gremirarunico/PCBs/README.md

# PCBs
## Informazioni
Repository privato per backup & share di PCB realizzati con KiCAD

## KiCad version
7.0.8

## License
Very easy to understand:
All the Hardware in this repository is under CERN-OHL-S v2
All the Software is under GPLv3
All the documentation is under CC-BY-SA 4.0
