gremirarunico/PCBs/MuReSC_BCD_v1/Docs/KL85_MuRESCC.docx

KL85

Multiple-Resonant Switched Capacitor Converter

Test Chip Manual

BCD110AP technology

Advanced IC & Technology Sensitive IPs Design

Smart Power & High Voltage Competence Center

Front-end Technology and Manufacturing - FTM R&D

STMicroelectronics S.r.l.

Castelletto – Italy

Revision 0.1

The purpose of this document is to describe content and control instructions of KL85AA chip included in HI13AA multi-chip in BCD110AP technology, which integrates a Multiple-Resonant Switched Capacitor Converter (MuReSCC), including

- Comparator
- 13MHz clock
- Comparator
- Phase generator with programmable delays
- Drivers
- Output stage

Additional cells are included to allow proper biasing

- Bandgap voltage reference
- PTAT and ZTAT current reference

The used back-end option is 4M2X1UNIPDPI (4 Metals, NiPd Pads with PI). The used front-end option is DTI, with both 1.8V and 5V Gate Oxides.

REVISION HISTORY

Revision | Authors | Release | Notes
0.1 | Alessandro Nicolosi | June 2024 | Document Creation

TECHNOLOGY AND OPERATING CONDITIONS

Name | Version
PDK_STM_BCD110AP | 3.1.a-00
MACROCELLS_ESD_BCD110AP | 1.2-00
BCD110AP_SC_13d5T_CORE_OD50 | 3.0-00
BCD110AP_SC_12T_CORE_H | 3.0-00
BCD110AP_SC_13d5TGO2_SHIFTJI_H_OD50 | 3.0-00
BCD110AP_IO_SFISO_GPIO_1V8_5V_OD50_4M2X1UNIPDPI | 1.0

# 1. Index of contents

# 2. Index of tables

# 3. Index of figures

# 4. KL85 Overview

EXT_REF_SNS_INT_REF

OSC_VCTRL

SEL_INT_REF

RESET

VBATT_COMP

VDD_IO

GND_IO

SENSE_CMP_OUT

SEL_OPEN_LOOP

V1V8

SENSE_OSC_CLK

SEL_CLK

## 4.1. PADRing

The external access (on wafer) to the testchip is shown in Figure 4-1:

48 47 46 45 44 43 42 41 40 39 38 37

ADT_D4

VBATT_PWR

VS1

VOUT

VOUT_SENSE

VS3

GND

VDD_IO

GND_IO

VBATT_DRV

VG4

VG3

EXT_CLK

DT_D0

DT_D1

DT_D2

DT_D3

DT_D4

VDD_IO

GND_IO

ADT_D0

ADT_D1

ADT_D2

ADT_D3

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
13 14 15 16 17 18 19 20 21 22 23 24

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
VBATT

IPTAT_SENSE

IZTAT_SENSE

DRIVE_G1

DRIVE_G2

GND_IO

VDD_IO

DRIVE_G3

DRIVE_G4

SEL_DRIVING

VG1

VG2

Figure 4-1 KL85 Padring and Pinout

In the following table the 48 PADs of the KL85 and their coordinates are reported. All dimensions are provided at CAD level (pre-shrink). To get coordinates at silicon level, you need to apply the optical shrink factor (8%).

Pin count | Name | Type | Description | X | Y
1 | VBATT | SUPPLY | Main input voltage supply for bandgap and current reference
2 | IPTAT_SENSE | ANALOG | Sensing of internal PTAT current reference
3 | IZTAT_SENSE | ANALOG | Sensing of internal ZTAT current reference
4 | DRIVE_G1 | DIG IN | Direct command for driver 1
5 | DRIVE_G2 | DIG IN | Direct command for driver 2
6 | GND_IO | GROUND | Ground for IOs
7 | VDD_IO | SUPPLY | Voltage supply for IOs
8 | DRIVE_G3 | DIG IN | Direct command for driver 3
9 | DRIVE_G4 | DIG IN | Direct command for driver 4
10 | SEL_DRIVING | DIG IN | Selector between internal/external commands for drivers
11 | VG1 | DIG OUT | Pre-driver output 1
12 | VG2 | DIG OUT | Pre-driver output 2
13 | VG3 | DIG OUT | Pre-driver output 3
14 | VG4 | DIG OUT | Pre-driver output 4
15 | VBATT_DRV | SUPPLY | Main input voltage supply for drivers
16 | GND_IO | GROUND | Ground for IOs
17 | VDD_IO | SUPPLY | Voltage supply for IOs
18 | GND | GROUND | Analog and power and substrate ground
19 | VS3 | ANALOG | Intermediate output voltage 3
20 | VOUT_SENSE | ANALOG | Sensing of the output voltage
21 | VOUT | ANALOG | Output voltage
22 | VS1 | ANALOG | Intermediate output voltage 1
23 | VBATT_PWR | SUPPLY | Main input voltage supply for output stage
24 | ADT_D4 | DIG IN | Additional dead time bit 4
25 | ADT_D3 | DIG IN | Additional dead time bit 3
26 | ADT_D2 | DIG IN | Additional dead time bit 2
27 | ADT_D1 | DIG IN | Additional dead time bit 1
28 | ADT_D0 | DIG IN | Additional dead time bit 0
29 | GND_IO | GROUND | Ground for IOs
30 | VDD_IO | SUPPLY | Voltage supply for IOs
31 | DT_D4 | DIG IN | Dead time bit 4
32 | DT_D3 | DIG IN | Dead time bit 3
33 | DT_D2 | DIG IN | Dead time bit 2
34 | DT_D1 | DIG IN | Dead time bit 1
35 | DT_D0 | DIG IN | Dead time bit 0
36 | EXT_CLK | DIG IN | External clock
37 | SEL_CLK | DIG IN | Selector between internal and external clock
38 | SENSE_OSC_CLK | DIG OUT | Oscillator output
39 | V1V8 | SUPPLY | Input voltage supply for 1.8V Circuits
40 | SEL_OPEN_LOOP | DIG IN | Selector between closed and open loop regulation
41 | SENSE_CMP_OUT | DIG OUT | Comparator output
42 | GND_IO | GROUND | Ground for IOs
43 | VDD_IO | SUPPLY | Voltage supply for IOs
44 | VBATT_COMP | SUPPLY | Main input voltage supply for comparator
45 | RESET | DIG IN | Digital global reset (active low)
46 | SEL_INT_REF | DIG IN | Reference Selector
47 | OSC_VCTRL | ANALOG | Oscillator control voltage
48 | EXT_REF_SNS_INT_REF | ANALOG | External reference to bypass internal bandgap or sensing of internal reference

Table 4-1 KL85 Pin list
