gremirarunico/PCBs/MuReSC_GaN_v1/Bom.xlsx

Part number | Farnell number | RS number | Package | Value | Component | Number per part | Description | Price per part | Total price
C1812C124J1GACTU | 2906201 | 146-4328 | 1812 | 120n | C1 | 1 | capacita anello risonanza principle | 1.95 | 1.95
C1206C821J1GACTU |  |  | 1206 | 820p | C2 | 1 | anello multi-risonanza | 0.288 | 0.288
C1812C105K1RACTU | 2522546 |  | 1812 | 1u | Cout | 1 | capacita di uscita | 0.735 | 0.735
ISO7720FD |  |  |  |  |  | 4 | isolatore segnale | 2.26 | 9.04
GS61004B-TR |  |  |  |  |  | 4 | dispositivo di potenza | 6.68 | 26.72
LMG1020YFFR |  | 252-8691 |  |  |  | 4 | Driver GaN | 4.13 | 16.52
TPSM5601R5HRDAR |  |  |  |  |  | 1 | Buck per la logica | 7.29 | 7.29
 |  |  |  |  |  |  |  |  | 0
GRT155R70J105KE01D |  | 260-8843 | 402 | 1u | CD1-4,CLD2,CM5,CM8 | 7 | capacità bypass grande per driver | 0.102 | 0.714
NFM15PC104R1A3D |  |  |  | 0.1u | L2-5 | 4 | capacità bypass per driver | 0.093 | 0.372
MCS0402MC1008FE000 | min 10k 3782647 |  | 402 |  | RH1-4,RL1-4 | 8 | resistenze gate driver | 0.326 | 2.608
MCS04020D1002BE000 |  |  | 402 | 10k | RF1,RM1 | 2 |  | 0.428 | 0.856
MCS04020D2491BE000 |  |  | 402 | 2.49k | RF2 | 1 |  | 0.419 | 0.419
GRJ31CZ72A475KE01L |  |  | 1206 | 4.7u | CIN1,CIN2,CPIN1,CPIN2 | 4 |  | 0.67 | 2.68
C1210C107M8PACTU | 2442786 | 841-0809 | 1210 | 100u | CCV1, CCV2 | 2 |  | 1.04 | 2.08
C0402C104K8RACTU | 2429351 |  | 402 | 100n | CM1-4,6-7,9-10, CISOP1-4, CISOS1-4, CTP1-4, CTS1-4 | 24 |  | 0.093 | 2.232
GRM155R61A475MEAAD | 2688503 |  | 402 | 4.7u | CM0 | 1 |  | 0.121 | 0.121
GRM155Z71A105KE01J | 4128556 |  | 402 | 1u | CLD1 | 1 |  | 0.093 | 0.093
 |  |  |  |  |  |  |  |  | 0
 |  |  |  |  |  |  |  |  | 0
NX3215SA-32.768K-STD-MUS-2 |  |  |  |  |  | 1 | Oscillatore slow | 0.67 | 0.67
GRM0335C1E5R1BA01D |  |  | 201 | 5.1p | COL1-2 | 2 | capacità oscillatore slow | 0.093 | 0.186
GJM0335C1E6R8DB01D |  | 185-3344 | 201 | 6.8p | COH1-2 | 2 | capacità oscillatore fast | 0.093 | 0.186
NX3225SA-24.000M-STD-CSR-1 |  |  |  |  |  | 1 | oscillatore fast | 0.642 | 0.642
 |  |  |  |  |  |  |  |  | 0
PTS526SK15SMTR2LFS | 3780596 | 135-9519 |  |  | SW1-2 | 2 |  | 0.112 | 0.224
ESDALC6V1-1U2 | 1749278 |  | 201 |  | D1-2 | 2 |  | 0.363 | 0.726
MCS04020C3300FE000 | 3546556 |  | 402 | 330 | RUB1 | 1 |  | 0.149 | 0.149
MCS04020C1003FE000 | 2614407 | 188-5959 (https://it.rs-online.com/web/p/resistenze-smd/1885959) | 402 | 100k | RUB2 | 1 |  | 0.149 | 0.149
 |  |  |  |  |  |  |  |  | 0
BLM15AG601SZ1D |  | 104-8521 | 402 |  | BEAD1-2 | 2 |  | 0.093 | 0.186
C0603C106M8PAC7411 | 3508556 |  | 603 |  | CTPB1-4,CTSB1-4 | 8 |  | 0.409 | 3.272
 |  |  |  |  |  |  |  |  | 0
 |  |  |  |  |  |  |  |  | 0
TSZU52C3V3 RGG |  |  |  |  | D3-6 | 3 | zener clamping | 0.409 | 1.227
 |  |  |  |  |  |  |  |  | 0
RT0603DRE077K41L |  |  | 603 | 7.41k | RS2,3 | 2 |  | 0.093 | 0.186
RT0603DRE10100KL | 4013917 |  | 603 | 100k | RS1,4,5,8 | 4 |  | 0.093 | 0.372
RP0603BRD075K76L | 4079327 |  | 603 | 5.76k | RS6,RS7 | 2 |  | 0.363 | 0.726
2222SQ-221GEC | 2287145 |  |  | 220nH | L1 |  |  |  | 0
RP73PF1E2K74BTD | 2944494 |  | 402 | 2.74 | RH1-4,RL1-4 | 8 | Resistenza di gate driver alternativa | 0.316 | 2.528
62000211121 | 3583826 | 233-9506 (https://it.rs-online.com/web/p/strip-e-connettori-pcb/2339506) |  |  |  | 1 |  | 0.307 | 0.307
UCC12040DVE |  |  |  |  |  | 4 | Trasformatore di isolamento | 4.64 | 18.56
LD39050PU33R | 2762703 | 196-1948 (https://it.rs-online.com/web/p/regolatori-di-tensione/1961948) |  |  |  | 1 |  | 1.38 | 1.38
STM32G474RET6 | 3132418 | 193-9861 (https://it.rs-online.com/web/p/microcontroller/1939861) |  |  |  | 1 | micro | 10.42 | 10.42
691214110002 | 1841250 | 191-0080 (https://it.rs-online.com/web/p/morsetti-pcb/1910080) |  |  |  | 2 |  | 0.902 | 1.804
 |  |  |  |  |  |  |  | TOTAL | 118.618
