gremirarunico/PCBs/MuReSC_BCD_v1/Docs/Pins.xlsx

Sheet: Sheet1
Power pins
VBATT | power | Alimentazione 5V per componenti accessori
VBATTDRIVER | power | Alimentazione 5V per driving power MOS
VBATTPOWER | power | Alimentazione 5V per la conversione
gnd | power | ground
1v8 | power | 1.8V per alimentazione logica
Config pin |  | disponibili per registri
adt_0 | digital | Configurazione ritardo 4° MOS
adt_1 | digital
adt_2 | digital
adt_3 | digital
adt_4 | digital
dt_d0 | digital | Configurazione Dead Time
dt_d1 | digital
dt_d2 | digital
dt_d3 | digital
dt_d4 | digital
INPUT PIN
DRIVE_G1 | digital | Manual driving gate
DRIVE_G2 | digital
DRIVE_G3 | digital
DRIVE_G4 | digital
SEL_DRIVING | digital | Selezione se driving esterno
SEL_OPENLOOP | digital | Seleziona se attivare o disattivare il controllo interno ad isteresi
EXT_CLK | digital | Clock esterno se desiderato
SEL_CLK | digital | Selezione clock esterno
OUTPUTPIN
VG1 | analog | Tensione sense per gate power MOS
VG2 | analog
VG3 | analog
VG4 | analog
Vout | analog | Uscita
VS3 | analog | Pin Induttanza
VS1 | analog | Pin capacità monorisonanza
SENSE_OSC_CLK | digital | Clock interno fuori

Sheet: Sheet2
PINLIST
# | NAME | ACCESS | DESCRIPTION
1 | VBATT | SUPPLY | Main input voltage supply for bandgap and current reference | BG
2 | IPTAT_SENSE | ANALOG | Sensing of internal PTAT current reference | BG
3 | IZTAT_SENSE | ANALOG | Sensing of internal ZTAT current reference | BG
4 | DRIVE_G1 | DIG IN | Direct command for driver 1 | DRV
5 | DRIVE_G2 | DIG IN | Direct command for driver 2 | DRV
6 | GND_IO | GROUND | Ground for IOs
7 | VDD_IO | SUPPLY | Voltage supply for IOs
8 | DRIVE_G3 | DIG IN | Direct command for driver 3 | DRV
9 | DRIVE_G4 | DIG IN | Direct command for driver 4 | DRV
10 | SEL_DRIVING | DIG IN | Selector between internal/external commands for drivers | DRV
11 | VG1 | DIG OUT | Pre-driver output 1 | DRV
12 | VG2 | DIG OUT | Pre-driver output 2 | DRV
13 | VG3 | DIG OUT | Pre-driver output 3 | DRV
14 | VG4 | DIG OUT | Pre-driver output 4 | DRV
15 | VBATT_DRV | SUPPLY | Main input voltage supply for drivers | DRV
16 | GND_IO | GROUND | Ground for IOs
17 | VDD_IO | SUPPLY | Voltage supply for IOs
18 | GND | GROUND | Analog and power and substrate ground | PWR
19 | VS3 | ANALOG | Intermediate output voltage 3 | PWR
20 | VOUT_SENSE | ANALOG | Sensing of the output voltage | PWR
21 | VOUT | ANALOG | Output voltage | PWR
22 | VS1 | ANALOG | Intermediate output voltage 1 | PWR
23 | VBATT_POWER | SUPPLY | Main input voltage supply for output stage | PWR
24 | ADT_D4 | DIG IN | Additional dead time bit 4 | DRV
25 | ADT_D3 | DIG IN | Additional dead time bit 3 | DRV
26 | ADT_D2 | DIG IN | Additional dead time bit 2 | DRV
27 | ADT_D1 | DIG IN | Additional dead time bit 1 | DRV
28 | ADT_D0 | DIG IN | Additional dead time bit 0 | DRV
29 | GND_IO | GROUND | Ground for IOs
30 | VDD_IO | SUPPLY | Voltage supply for IOs
31 | DT_D4 | DIG IN | Dead time bit 4 | DRV
32 | DT_D3 | DIG IN | Dead time bit 3 | DRV
33 | DT_D2 | DIG IN | Dead time bit 2 | DRV
34 | DT_D1 | DIG IN | Dead time bit 1 | DRV
35 | DT_D0 | DIG IN | Dead time bit 0 | DRV
36 | EXT_CLK | DIG IN | External clock | CLK
37 | SEL_CLK | DIG IN | Selector between internal and external clock | CLK
38 | SENSE_OSC_CLK | DIG OUT | Oscillator output | CLK
39 | V1V8 | SUPPLY | Input voltage supply for 1.8V Circuits | CLK
40 | SEL_OPEN_LOOP | DIG IN | Selector between closed and open loop regulation | COMP
41 | SENSE_CMP_OUT | DIG OUT | Comparator output | COMP
42 | GND_IO | GROUND | Ground for IOs
43 | VDD_IO | SUPPLY | Voltage supply for IOs
44 | VBATT_COMP | SUPPLY | Main input voltage supply for comparator | COMP
45 | RESET | DIG IN | Digital global reset (active low) | CLK
46 | SEL_INT_REF | DIG IN | Reference Selector | BG
47 | OSC_VCTRL | ANALOG | Oscillator control voltage | CLK
48 | EXT_REF_SNS_INT_REF | ANALOG | External reference to bypass internal bandgap or sense of internal reference | BG
