gremirarunico/PCBs/MuReSC_BCD_v1/Docs/BOM.xlsx

Cosa | Codice | Quantità ps | Quantità | Spiegazione | Costo per unità | Costo totale
LDO | SPX3819M5-L-1-8/TR | 1 | 10 |  | 0.38 € | 3.81 €
CAVO | 415-0199-MM500 | 0 | 8 | 4 canali oscilloscopio + 4 canali generatore di segnali | 9.72 € | 77.76 €
BNC | 60312002114503 | 13 | 50 |  | 5.36 € | 268.00 €
R100k | RT0603DRE10100KL | 21 |  |  | 0.09 €
Jumper | 382811-8 | 8 |  |  | 0.15 €
R1k | RP0603BRE071KL | 2 |  |  | 0.20 €
RV100k | TS63Y104KT20 | 1 |  |  | 2.67 €
INTERRUTTORE | 653-A6S-5102-H | 3 |  |  | 2.24 €
Clamp | 691214110002 | 3 | 0
L21.5nH | 0908SQ-22N | 1 |  |  | 2.16 €
L16.6nH | 0908SQ-17N
L14.7nH | 0908SQ-14N
L12.1nH | 0908SQ-12N
L8.1nH | 0908SQ-8N1
L23nH | 0908SQ-23N
l25nH | 0908SQ-25N
L27.3nH | 0908SQ-27N
https://www.coilcraft.com/getmedia/b4a6ff85-4c1f-448e-aea7-541369538706/sq_spring.pdf
