gremirarunico/PCBs/MuReSC_BCD_v1/MuReSC_BCD.kicad_pcb

## KiCad design MuReSC_BCD_v1/MuReSC_BCD.kicad_pcb (2025-04-28)

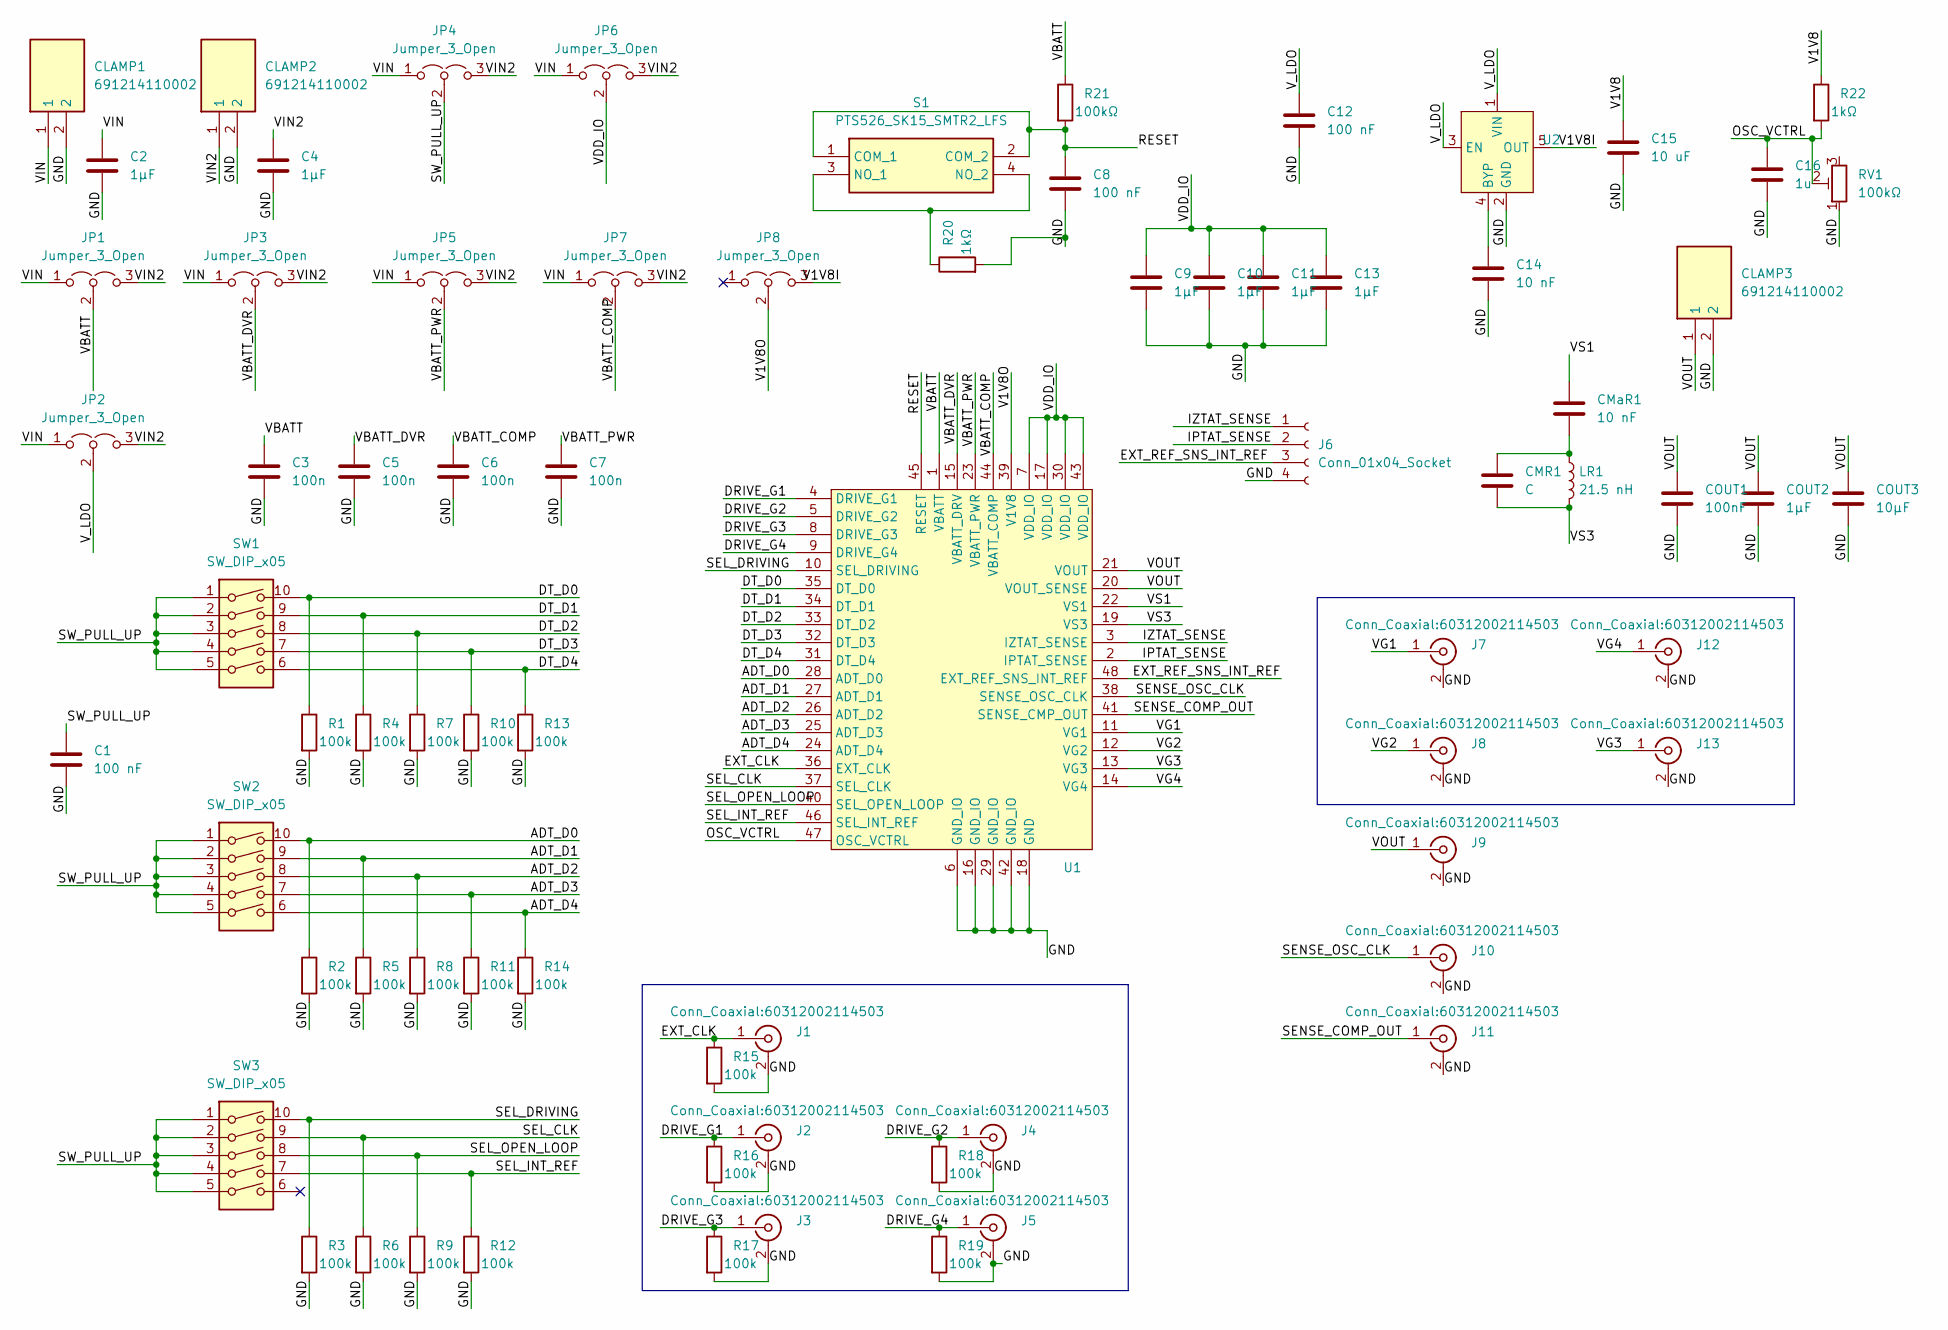
[picture p1: schematic MuReSC_BCD.kicad_sch]

Parts:
C1, C8, C12: 100 nF; C_0603_1608Metric_Pad1.08x0.95mm_HandSolder
C2, C4, C9, C10, C11, C13: 1µF; C_0603_1608Metric_Pad1.08x0.95mm_HandSolder
C3, C5, C6, C7: 100n; C_0603_1608Metric_Pad1.08x0.95mm_HandSolder
C14: 10 nF; C_0603_1608Metric_Pad1.08x0.95mm_HandSolder
C15: 10 uF; C_0603_1608Metric_Pad1.08x0.95mm_HandSolder
C16: 1u; C_0603_1608Metric_Pad1.08x0.95mm_HandSolder
CLAMP1, CLAMP2, CLAMP3: 691214110002; Mouser Part Number 710-691214110002
CMR1: C; C_0603_1608Metric_Pad1.08x0.95mm_HandSolder
CMaR1: 10 nF; C_0603_1608Metric_Pad1.08x0.95mm_HandSolder
COUT1: 100nF; C_0603_1608Metric_Pad1.08x0.95mm_HandSolder
COUT2: 1µF; C_0603_1608Metric_Pad1.08x0.95mm_HandSolder
COUT3: 10µF; C_0603_1608Metric_Pad1.08x0.95mm_HandSolder
J1, J2, J3, J4, J5, J7, J8, J9, J10, J11, J12, J13: Conn_Coaxial:60312002114503; SMA_Wurth_60312002114503_Vertical
J6: Conn_01x04_Socket; PinHeader_1x04_P2.54mm_Vertical
JP1, JP2, JP3, JP4, JP5, JP6, JP7, JP8: Jumper_3_Open; PinHeader_1x03_P2.54mm_Vertical
LR1: 21.5 nH; Coilcraft-Square-Air-Core-Inductors-all
R1, R2, R3, R4, R5, R6, R7, R8, R9, R10, R11, R12, R13, R14, R15, R16, R17, R18, R19: 100k; R_0603_1608Metric_Pad0.98x0.95mm_HandSolder
R20, R22: 1kΩ; R_0603_1608Metric_Pad0.98x0.95mm_HandSolder
R21: 100kΩ; R_0603_1608Metric_Pad0.98x0.95mm_HandSolder
RV1: 100kΩ; TS63X-VISHAY
S1: PTS526_SK15_SMTR2_LFS; PTS526SK15SMTR2LFS; Mouser Part Number 611-PTS526SK15SMR2L
SW1, SW2, SW3: SW_DIP_x05; DIP-10_W10.16mm_LongPads
U1: TQFP-48_7x7mm_P0.5mm
U2: SOT-23-5_HandSoldering

Connections:
/ADT_D0: R2.1, SW2.10, U1.28 (ADT_D0)
/ADT_D1: R5.1, SW2.9, U1.27 (ADT_D1)
/ADT_D2: R8.1, SW2.8, U1.26 (ADT_D2)
/ADT_D3: R11.1, SW2.7, U1.25 (ADT_D3)
/ADT_D4: R14.1, SW2.6, U1.24 (ADT_D4)
/DRIVE_G1: J2.1 (In), R16.1, U1.4 (DRIVE_G1)
/DRIVE_G2: J4.1 (In), R18.1, U1.5 (DRIVE_G2)
/DRIVE_G3: J3.1 (In), R17.1, U1.8 (DRIVE_G3)
/DRIVE_G4: J5.1 (In), R19.1, U1.9 (DRIVE_G4)
/DT_D0: R1.1, SW1.10, U1.35 (DT_D0)
/DT_D1: R4.1, SW1.9, U1.34 (DT_D1)
/DT_D2: R7.1, SW1.8, U1.33 (DT_D2)
/DT_D3: R10.1, SW1.7, U1.32 (DT_D3)
/DT_D4: R13.1, SW1.6, U1.31 (DT_D4)
/EXT_CLK: J1.1 (In), R15.1, U1.36 (EXT_CLK)
/EXT_REF_SNS_INT_REF: J6.3, U1.48 (EXT_REF_SNS_INT_REF)
/GND: C1.2, C2.2, C3.2, C4.2, C5.2, C6.2, C7.2, C8.2, C9.2, C10.2, C11.2, C12.2, C13.2, C14.2, C15.2, C16.2, CLAMP1.2, CLAMP2.2, CLAMP3.2, COUT1.2, COUT2.2, COUT3.2, J1.2 (Ext), J2.2 (Ext), J3.2 (Ext), J4.2 (Ext), J5.2 (Ext), J6.4, J7.2 (Ext), J8.2 (Ext), J9.2 (Ext), J10.2 (Ext), J11.2 (Ext), J12.2 (Ext), J13.2 (Ext), R1.2, R2.2, R3.2, R4.2, R5.2, R6.2, R7.2, R8.2, R9.2, R10.2, R11.2, R12.2, R13.2, R14.2, R15.2, R16.2, R17.2, R18.2, R19.2, R20.2, RV1.1, U1.6 (GND_IO), U1.16 (GND_IO), U1.18 (GND), U1.29 (GND_IO), U1.42 (GND_IO), U2.2 (GND)
/IPTAT_SENSE: J6.2, U1.2 (IPTAT_SENSE)
/IZTAT_SENSE: J6.1, U1.3 (IZTAT_SENSE)
/OSC_VCTRL: C16.1, R22.2, RV1.2, U1.47 (OSC_VCTRL)
/RESET: C8.1, R21.2, S1.1 (COM_1), S1.2 (COM_2), U1.45 (RESET)
/SEL_CLK: R6.1, SW3.9, U1.37 (SEL_CLK)
/SEL_DRIVING: R3.1, SW3.10, U1.10 (SEL_DRIVING)
/SEL_INT_REF: R12.1, SW3.7, U1.46 (SEL_INT_REF)
/SEL_OPEN_LOOP: R9.1, SW3.8, U1.40 (SEL_OPEN_LOOP)
/SENSE_COMP_OUT: J11.1 (In), U1.41 (SENSE_CMP_OUT)
/SENSE_OSC_CLK: J10.1 (In), U1.38 (SENSE_OSC_CLK)
/SW_PULL_UP: C1.1, JP4.2 (C), SW1.1, SW1.2, SW1.3, SW1.4, SW1.5, SW2.1, SW2.2, SW2.3, SW2.4, SW2.5, SW3.1, SW3.2, SW3.3, SW3.4, SW3.5
/V1V8: C15.1, R22.1
/V1V8I: JP8.3 (B), U2.5 (OUT)
/V1V8O: JP8.2 (C), U1.39 (V1V8)
/VBATT: C3.1, JP1.2 (C), R21.1, U1.1 (VBATT)
/VBATT_COMP: C6.1, JP7.2 (C), U1.44 (VBATT_COMP)
/VBATT_DVR: C5.1, JP3.2 (C), U1.15 (VBATT_DRV)
/VBATT_PWR: C7.1, JP5.2 (C), U1.23 (VBATT_PWR)
/VDD_IO: C9.1, C10.1, C11.1, C13.1, JP6.2 (C), U1.7 (VDD_IO), U1.17 (VDD_IO), U1.30 (VDD_IO), U1.43 (VDD_IO)
/VG1: J7.1 (In), U1.11 (VG1)
/VG2: J8.1 (In), U1.12 (VG2)
/VG3: J13.1 (In), U1.13 (VG3)
/VG4: J12.1 (In), U1.14 (VG4)
/VIN: C2.1, CLAMP1.1, JP1.1 (A), JP2.1 (A), JP3.1 (A), JP4.1 (A), JP5.1 (A), JP6.1 (A), JP7.1 (A)
/VIN2: C4.1, CLAMP2.1, JP1.3 (B), JP2.3 (B), JP3.3 (B), JP4.3 (B), JP5.3 (B), JP6.3 (B), JP7.3 (B)
/VOUT: CLAMP3.1, COUT1.1, COUT2.1, COUT3.1, J9.1 (In), U1.20 (VOUT_SENSE), U1.21 (VOUT)
/VS1: CMaR1.1, U1.22 (VS1)
/VS3: CMR1.2, LR1.2, U1.19 (VS3)
/V_LDO: C12.1, JP2.2 (C), U2.1 (VIN), U2.3 (EN)
unnamed: CMR1.1, CMaR1.2, LR1.1
unnamed: R20.1, S1.3 (NO_1), S1.4 (NO_2)
unnamed: C14.1, U2.4 (BYP)

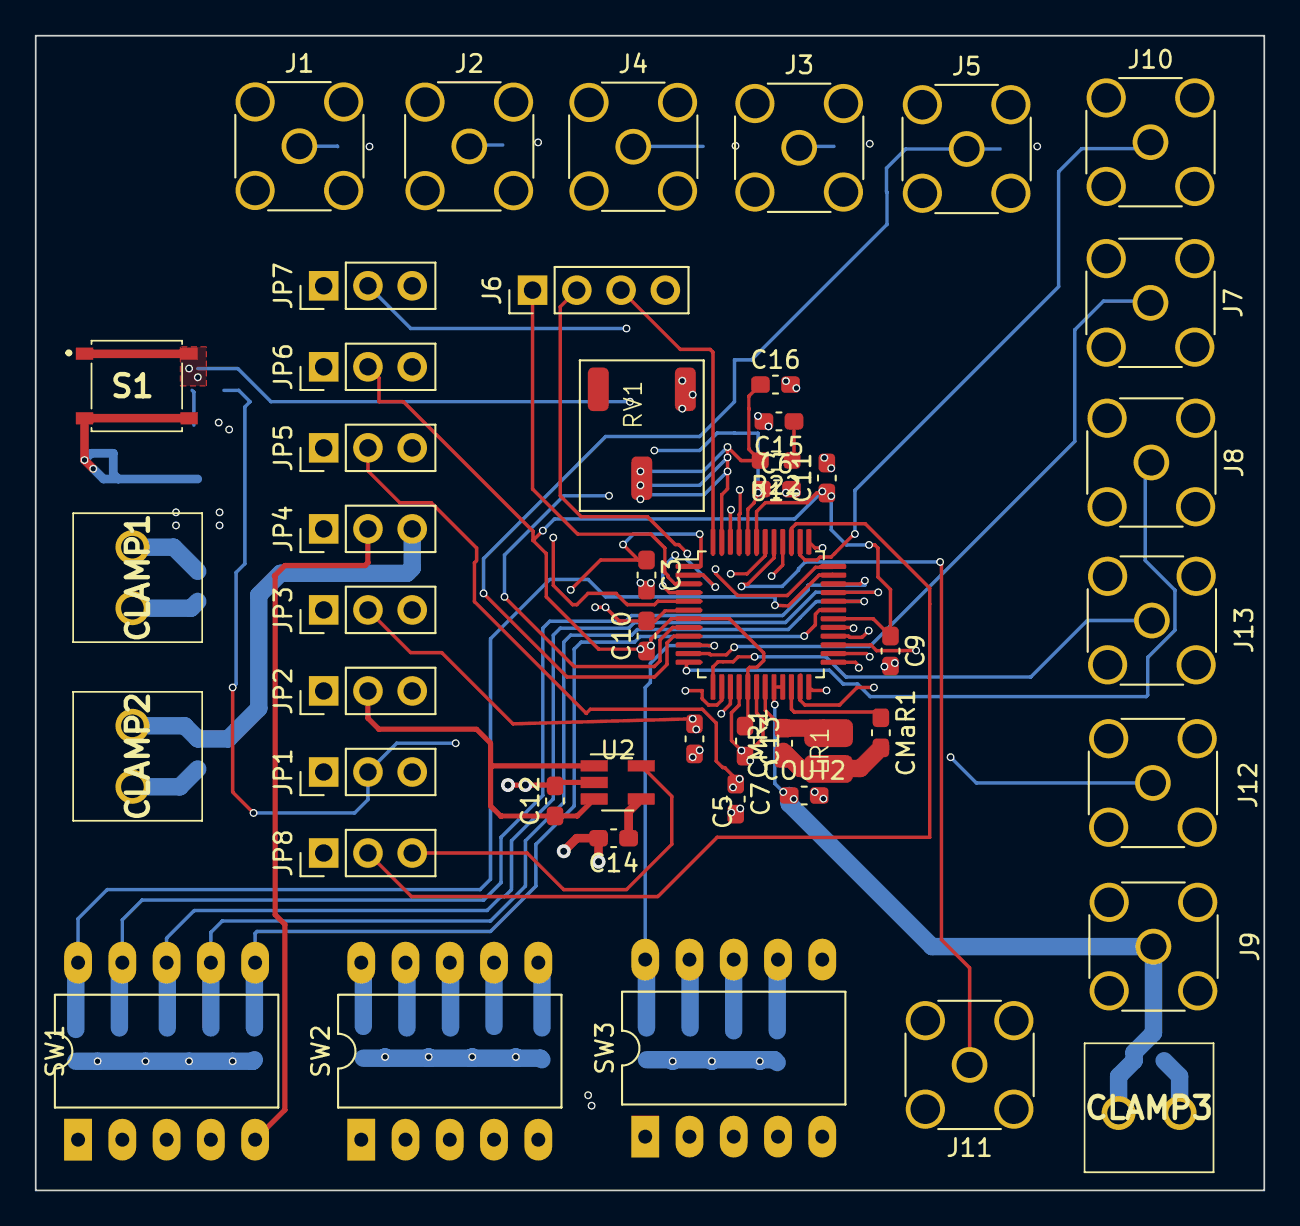
[picture p2: board MuReSC_BCD.kicad_pcb from above]

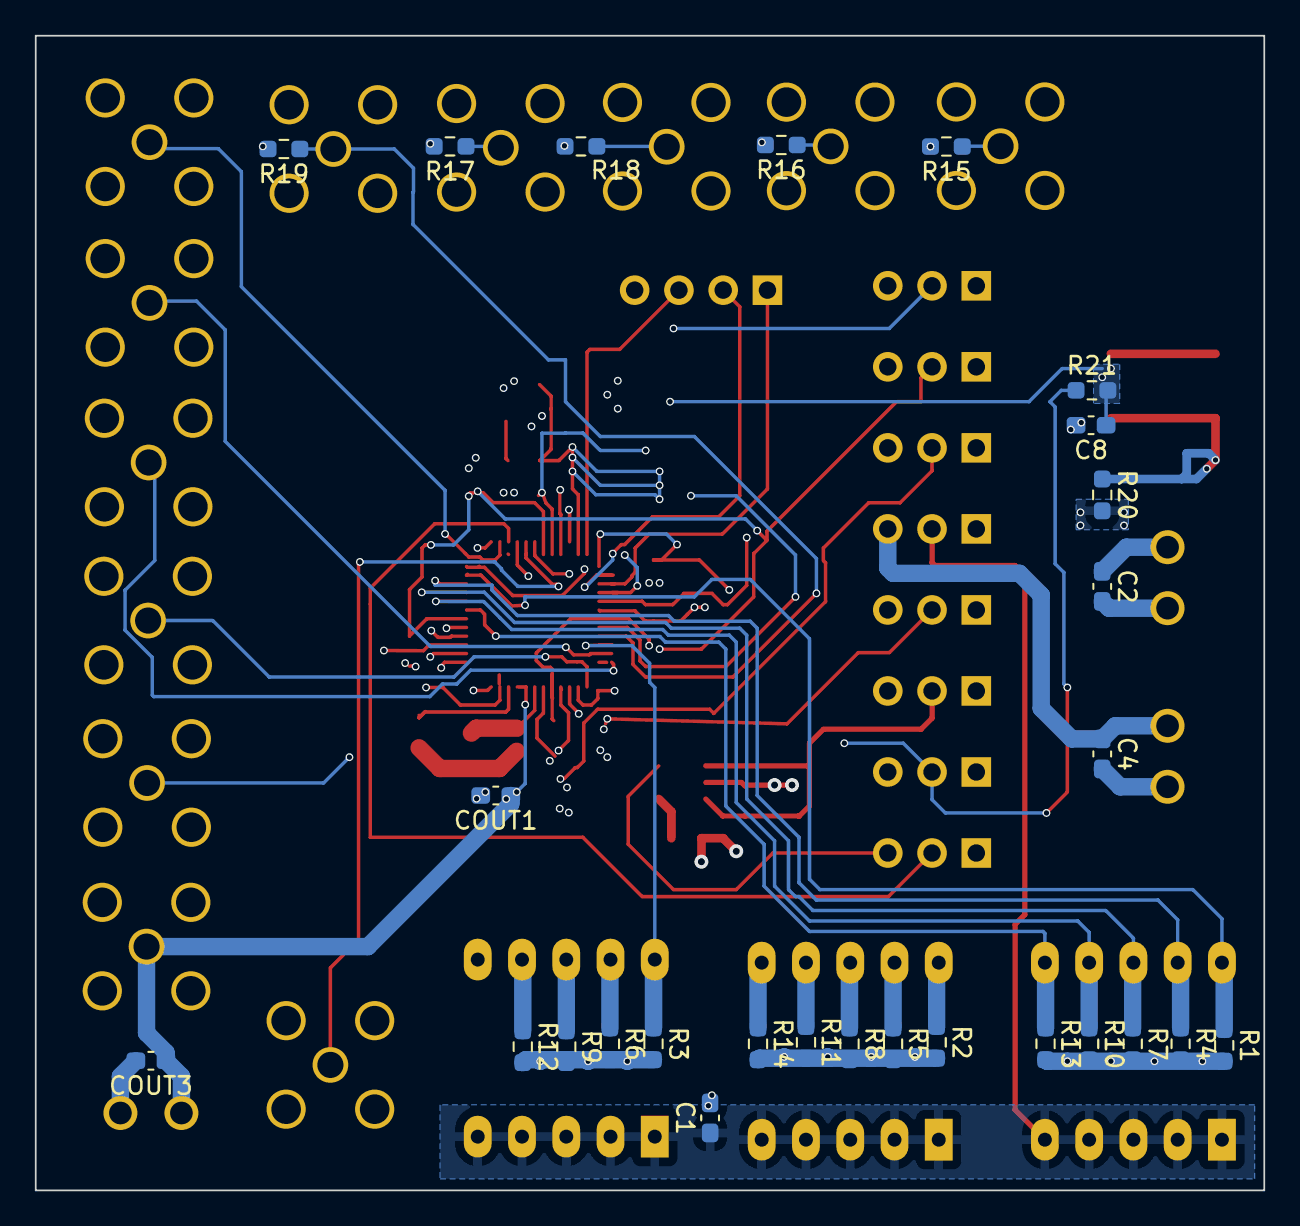
[picture p3: board MuReSC_BCD.kicad_pcb from below]

Board: 4 copper layers, 70.5 x 66.3 mm, 75 parts (27 on the bottom side), 49 nets.
