gremirarunico/PCBs/MuReSC_GaN_v1/Project.kicad_pcb

## KiCad design MuReSC_GaN_v1/Project.kicad_pcb (2025-04-16)

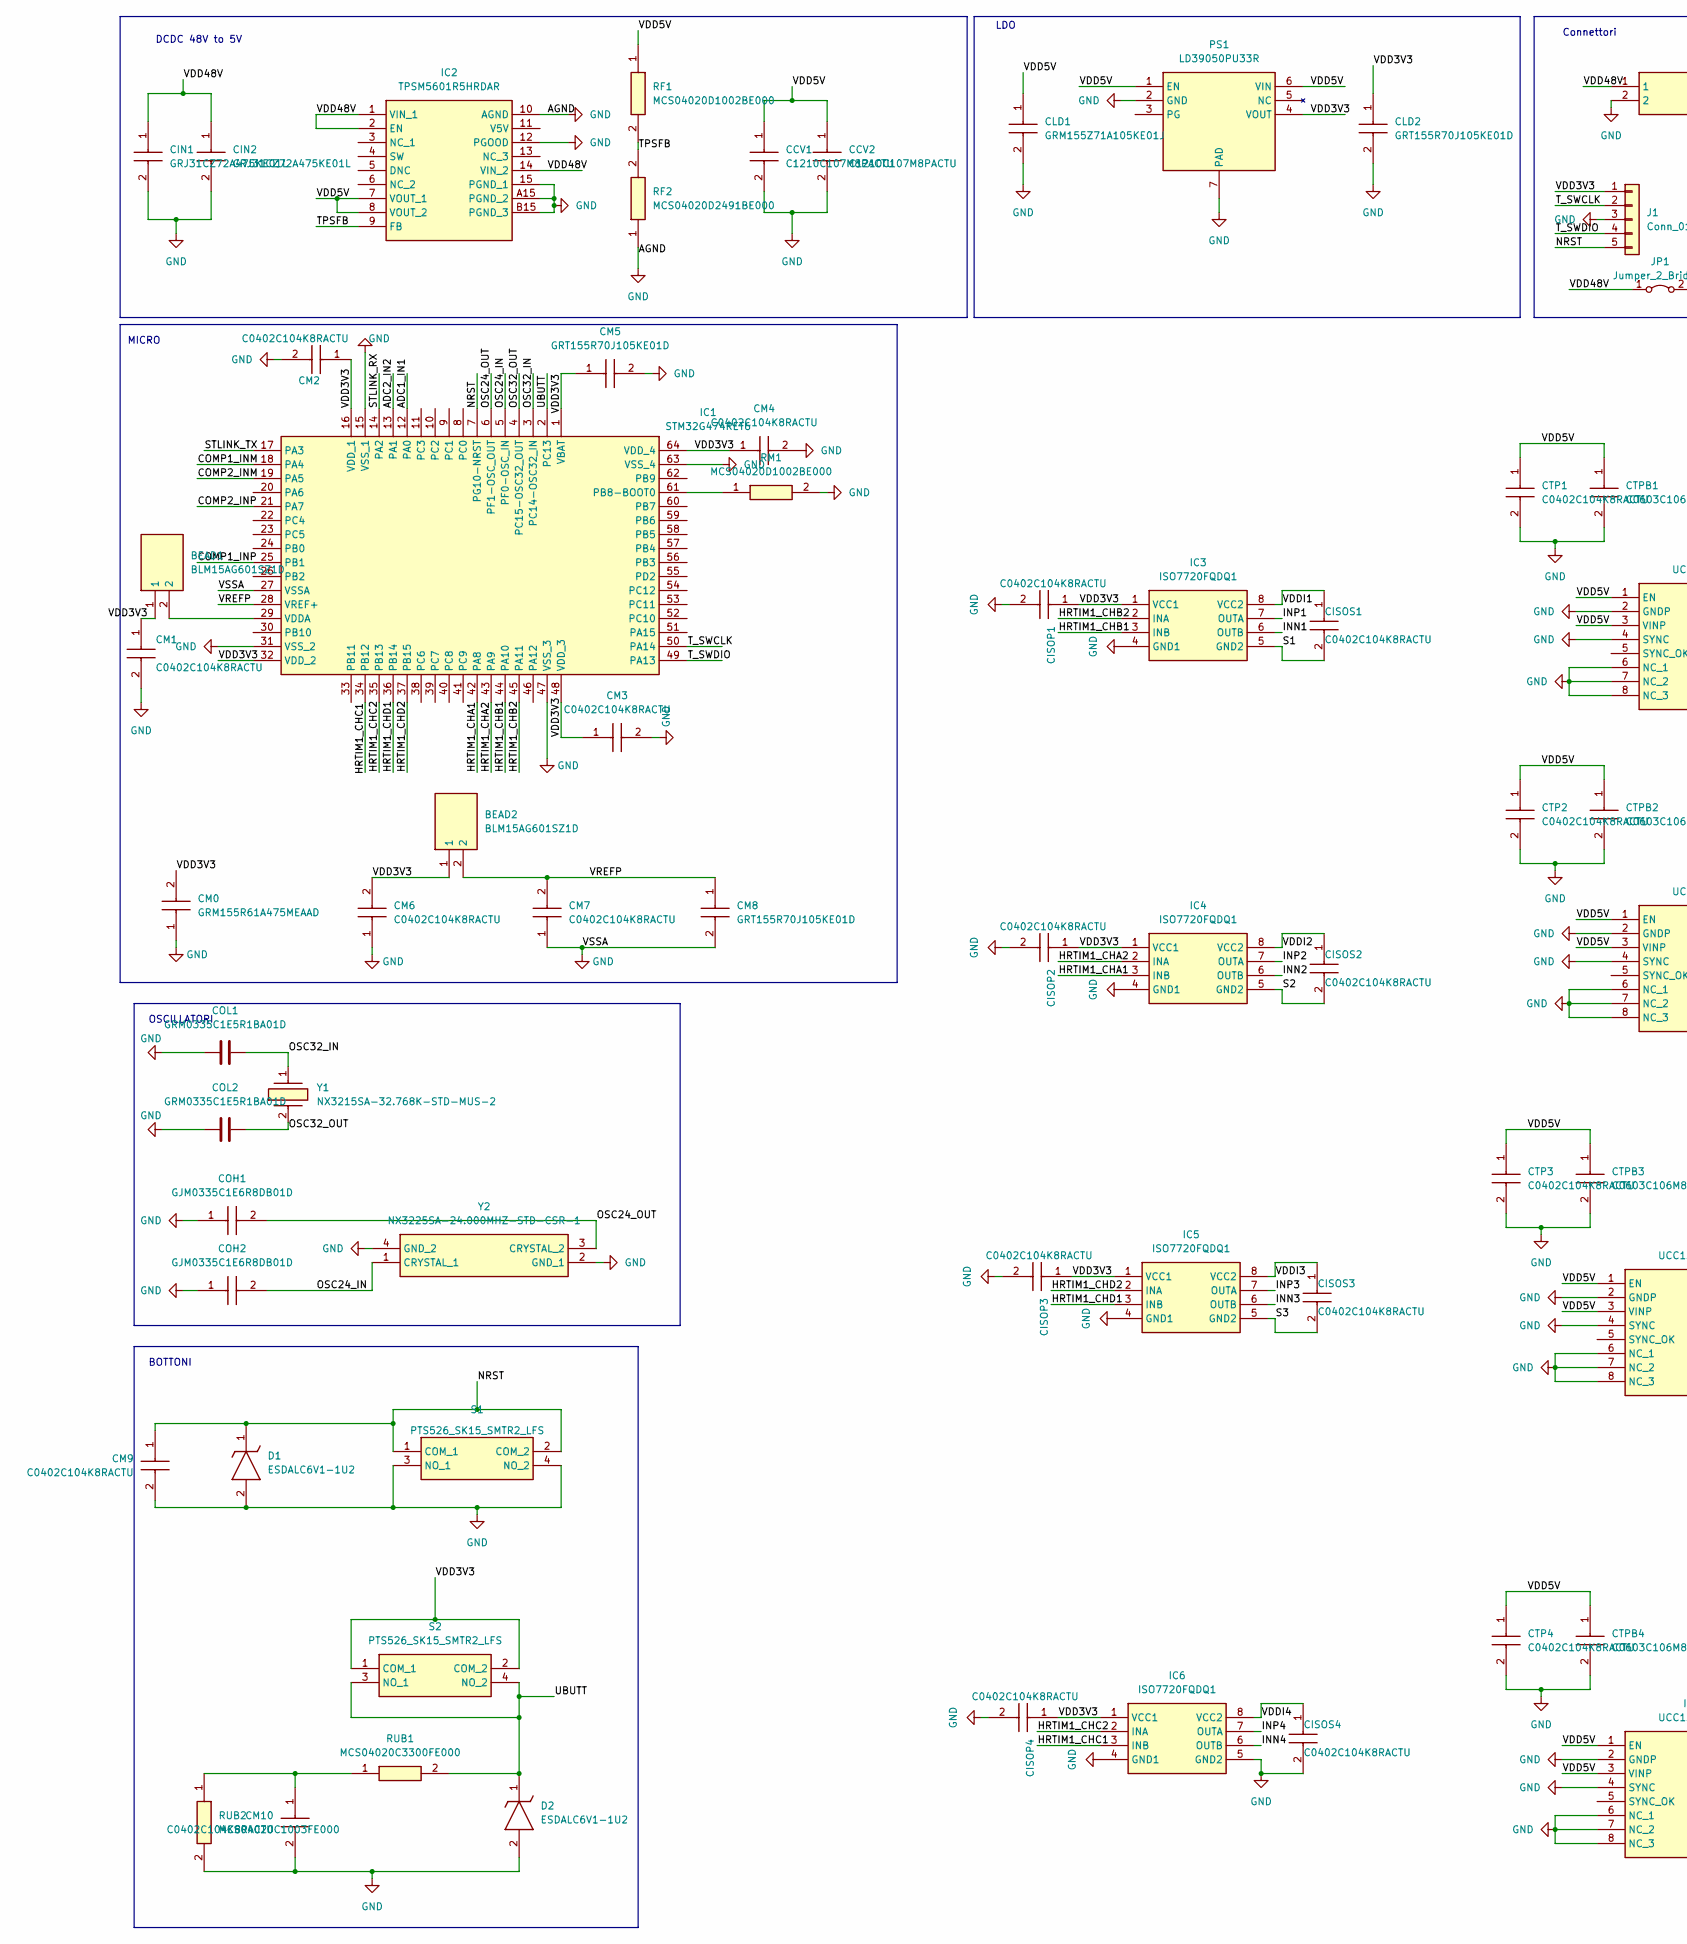
[picture p4: schematic Project.kicad_sch, part in row 1, column 1]

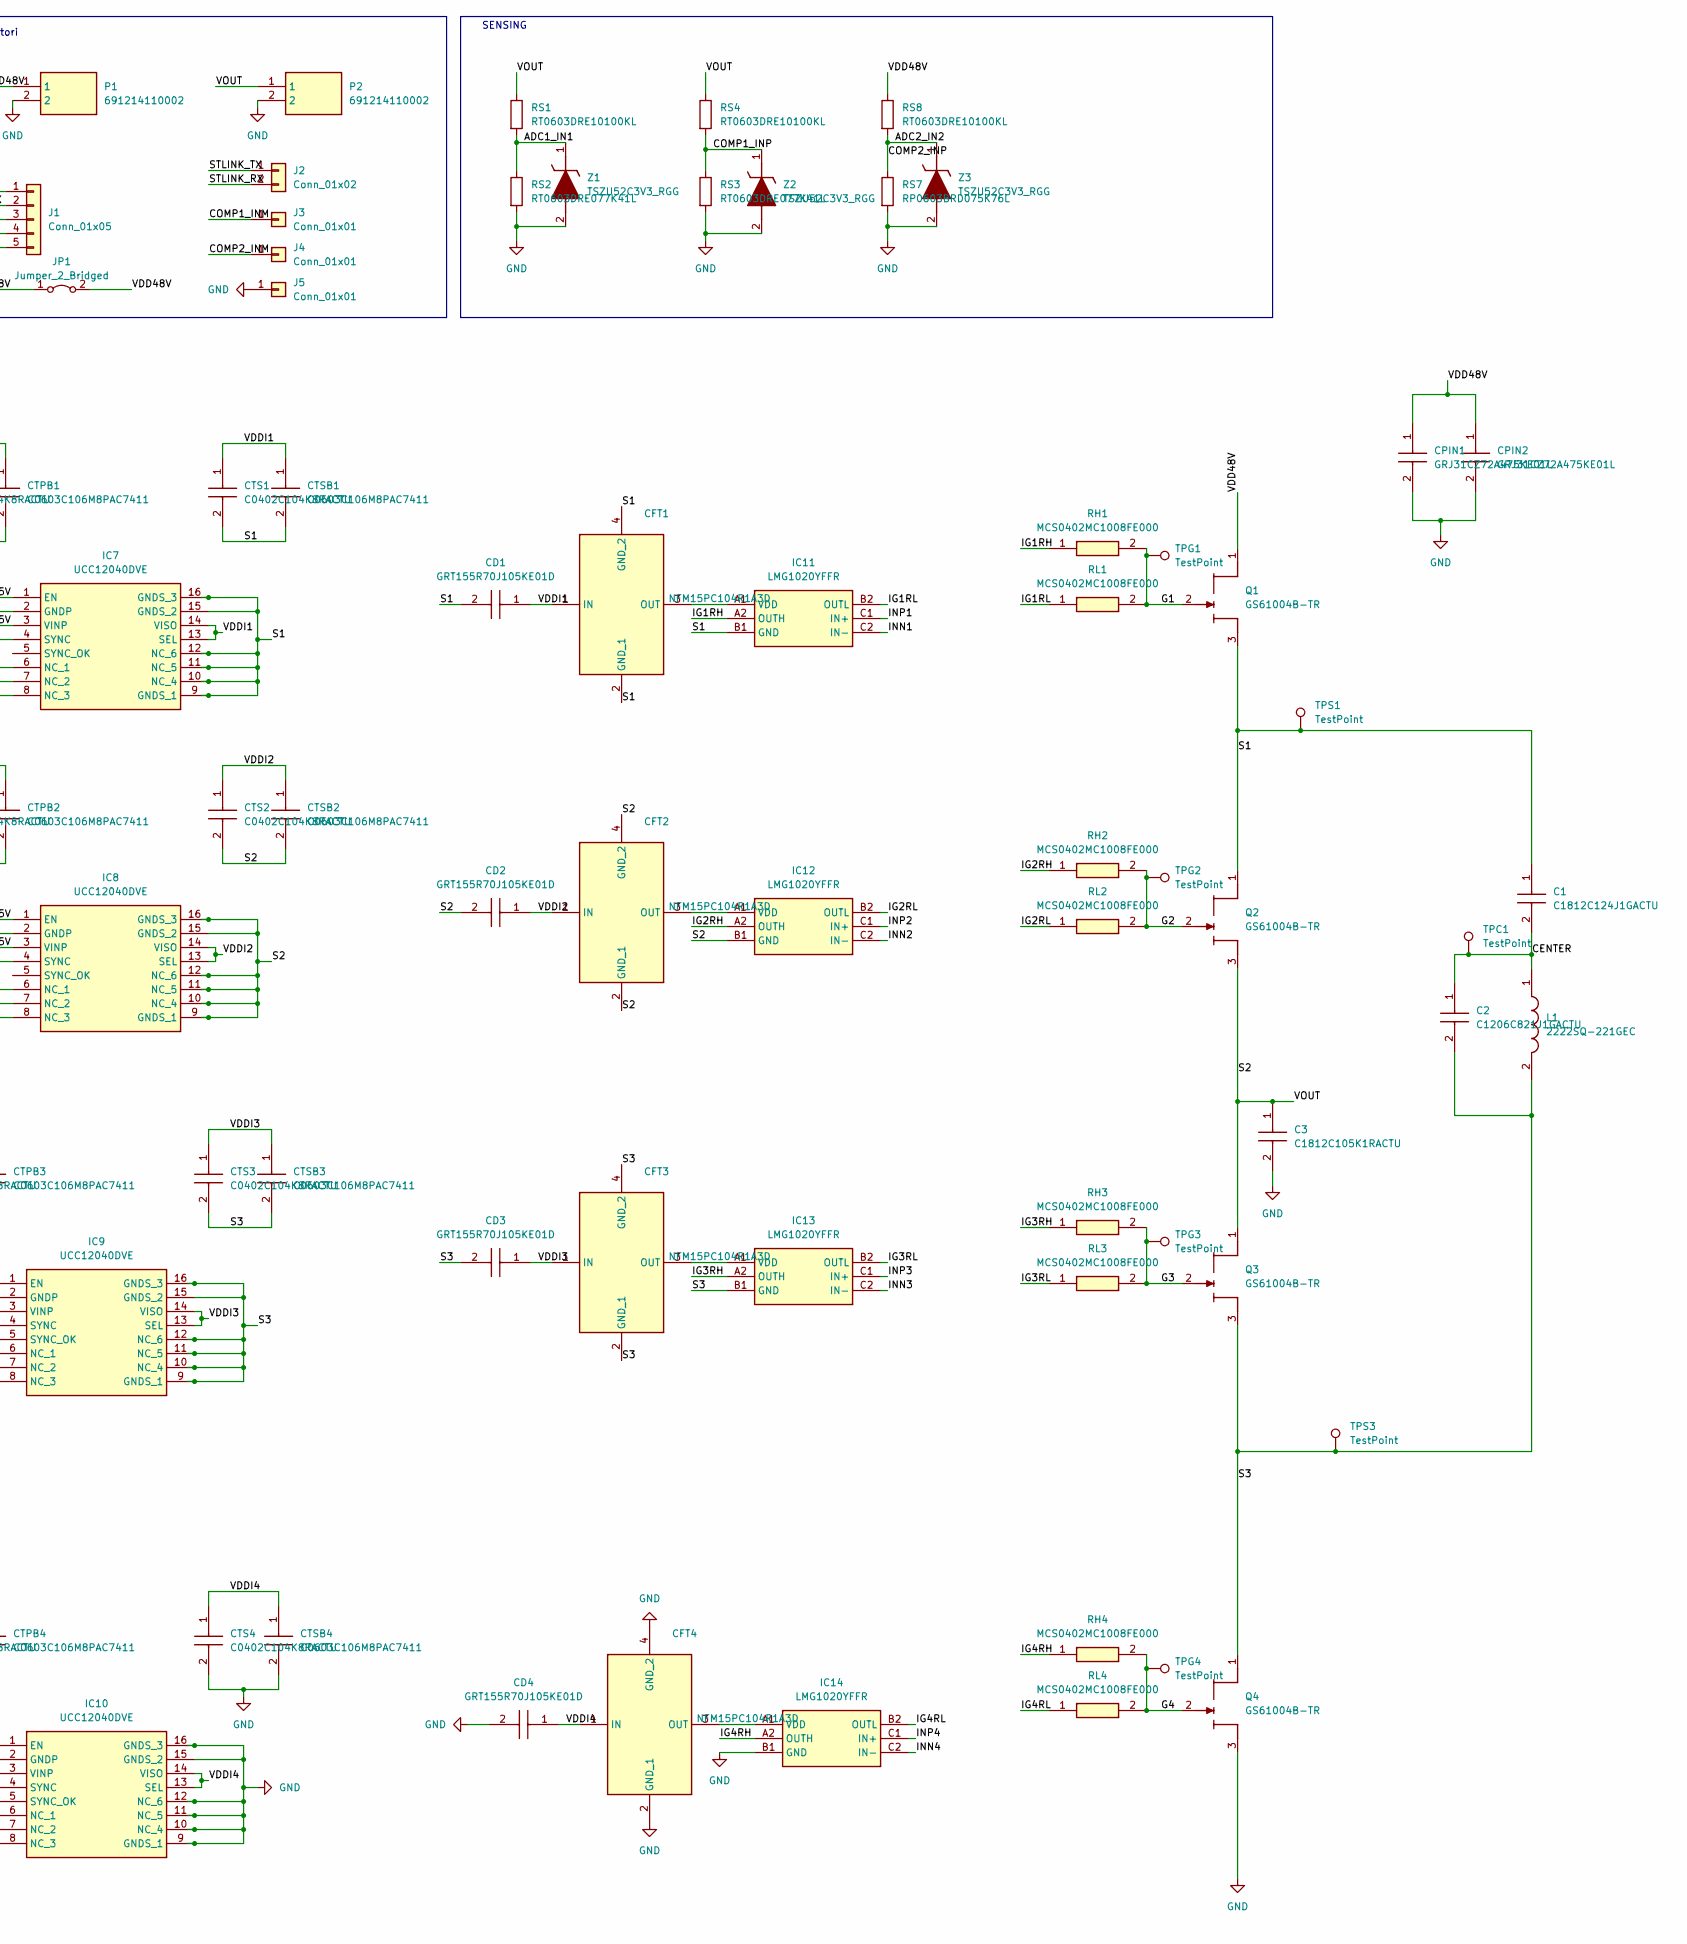
[picture p5: schematic Project.kicad_sch, part in row 1, column 2]

Parts:
BEAD1, BEAD2: BLM15AG601SZ1D; NFZ15SG152SN10B; Mouser Part Number 81-BLM15AG601SZ1D
C1: C1812C124J1GACTU; C1812; Mouser Part Number 80-C1812C124J1G
C2: C1206C821J1GACTU; C1206; Manufacturer_Part_Number C1206C821J1GACTU
C3: C1812C105K1RACTU; C1812; Mouser Part Number 80-C1812C105K1R
CCV1, CCV2: C1210C107M8PACTU; C1210; Mouser Part Number 80-C1210C107M8P
CD1, CD2, CD3, CD4: GRT155R70J105KE01D; CAPC1005X55N; Mouser Part Number 81-GRT155R70J105KE1D
CFT1, CFT2, CFT3, CFT4: NFM15PC104R1A3D; NFM15CC222D1A3D; Mouser Part Number 81-NFM15PC104R1A3D
CIN1, CIN2: GRJ31CZ72A475KE01L; CAPC3216X190N; Mouser Part Number 81-GRJ31CZ72A475KE1L
CISOP1, CISOP2, CISOP3, CISOP4: C0402C104K8RACTU; CAPC1005X55N; Mouser Part Number 81-GRT155R70J105KE1D
CISOS1, CISOS2, CISOS3, CISOS4: C0402C104K8RACTU; CAPC1005X55N; Mouser Part Number 81-GRT155R70J105KE1D
CLD1: GRM155Z71A105KE01J; CAPC1005X55N; Mouser Part Number 81-GRM155Z71A105KE1J
CLD2: GRT155R70J105KE01D; CAPC1005X55N; Mouser Part Number 81-GRT155R70J105KE1D
CM0: GRM155R61A475MEAAD; CAPC1005X55N; Mouser Part Number 81-GRM155R61A475MEAD
CM1, CM2, CM3, CM4, CM6, CM7, CM9, CM10: C0402C104K8RACTU; CAPC1005X55N; Mouser Part Number 80-C0402C104K8R7867
CM5, CM8: GRT155R70J105KE01D; CAPC1005X55N; Mouser Part Number 81-GRT155R70J105KE1D
COH1, COH2: GJM0335C1E6R8DB01D; CAPC0603X33N; Mouser Part Number 81-GJM0335C1E6R8DB1D
COL1, COL2: GRM0335C1E5R1BA01D; CAPC0603X33N
CPIN1, CPIN2: GRJ31CZ72A475KE01L; CAPC3216X190N; Mouser Part Number 81-GRJ31CZ72A475KE1L
CTP1, CTP2, CTP3, CTP4: C0402C104K8RACTU; CAPC1005X55N; Mouser Part Number 80-C0402C104K8R7867
CTPB1, CTPB2, CTPB3, CTPB4: C0603C106M8PAC7411; C0603; Mouser Part Number 80-C0603C106M8PLR
CTS1, CTS2, CTS3, CTS4: C0402C104K8RACTU; CAPC1005X55N; Mouser Part Number 80-C0402C104K8R7867
CTSB1, CTSB2, CTSB3, CTSB4: C0603C106M8PAC7411; C0603; Mouser Part Number 80-C0603C106M8PLR
D1, D2: ESDALC6V1-1U2; ESDALC6V11U2; Mouser Part Number 511-ESDALC6V1-1U2
IC1: STM32G474RET6; QFP50P1200X1200X160-64N; Mouser Part Number 511-STM32G474RET6
IC2: TPSM5601R5HRDAR; Mouser Part Number 595-TPSM5601R5HRDAR
IC3, IC4, IC5, IC6: ISO7720FQDQ1; SOIC127P600X175-8N; Mouser Part Number 595-ISO7720FQDQ1
IC7, IC8, IC9, IC10: UCC12040DVE; SOIC127P1030X265-16N; Mouser Part Number 595-UCC12040DVE
IC11, IC12, IC13, IC14: LMG1020YFFR; BGA6C40P2X3_86X126X62; Mouser Part Number 595-LMG1020YFFR
J1: Conn_01x05; PinHeader_1x05_P2.54mm_Horizontal
J2: Conn_01x02; PinHeader_1x02_P2.54mm_Horizontal
J3, J4, J5: Conn_01x01; PinHeader_1x01_P2.54mm_Vertical
JP1: Jumper_2_Bridged; PinHeader_1x02_P2.54mm_Horizontal
L1: 2222SQ-221GEC; 2222SQ221GEC; Mouser Part Number 994-2222SQ-221GEC
P1, P2: 691214110002; Mouser Part Number 710-691214110002
PS1: LD39050PU33R; SON95P300X300X100-7N-D; Mouser Part Number 511-LD39050PU33R
Q1, Q2, Q3, Q4: GS61004B-TR; GS61004BTR; Mouser Part Number 499-GS61004B-TR
RF1: MCS04020D1002BE000; RESC1005X37N; Mouser Part Number 594-MCS04020D1002BE0
RF2: MCS04020D2491BE000; RESC1005X37N; Mouser Part Number 594-MCS04020D2491BE0
RH1, RH2, RH3, RH4: MCS0402MC1008FE000; RESC1005X37N; Mouser Part Number 594-MCS0402MC1008FE0
RL1, RL2, RL3, RL4: MCS0402MC1008FE000; RESC1005X37N; Mouser Part Number 594-MCS0402MC1008FE0
RM1: MCS04020D1002BE000; RESC1005X37N; Mouser Part Number 594-MCS04020D1002BE0
RS1, RS4, RS8: RT0603DRE10100KL; R_0603_1608Metric_Pad0.98x0.95mm_HandSolder
RS2, RS3: RT0603DRE077K41L; R_0603_1608Metric_Pad0.98x0.95mm_HandSolder
RS7: RP0603BRD075K76L; R_0603_1608Metric_Pad0.98x0.95mm_HandSolder
RUB1: MCS04020C3300FE000; RESC1005X37N; Mouser Part Number 594-MCS04020C3300FE0
RUB2: MCS04020C1003FE000; RESC1005X37N; Mouser Part Number 594-MCS04020C1003FE0
S1, S2: PTS526_SK15_SMTR2_LFS; PTS526SK15SMTR2LFS; Mouser Part Number 611-PTS526SK15SMR2L
TPC1: TestPoint; TestPoint_Pad_1.0x1.0mm
TPG1, TPG2, TPG3, TPG4: TestPoint; TestPoint_Pad_1.0x1.0mm
TPS1, TPS3: TestPoint; TestPoint_Pad_1.0x1.0mm
Y1: NX3215SA-32.768K-STD-MUS-2; NX3215SA32768KSTDMUS2; Manufacturer_Part_Number NX3215SA-32.768K-STD-MUS-2
Y2: NX3225SA-24.000MHZ-STD-CSR-1; NX3225SA24000MHZSTDCSR1; Mouser Part Number 344-NX3225SA24MCSR1
Z1, Z2, Z3: TSZU52C3V3_RGG; TSZU52C3V3RGG; Mouser Part Number 821-TSZU52C3V3RGG

Connections:
/ADC1_IN1: IC1.12 (PA0), RS1.2, RS2.1, Z1.1 (K)
/ADC2_IN2: IC1.13 (PA1), IC1.21 (PA7), RS7.1, RS8.2, Z3.1 (K)
/CENTER: C1.2, C2.1, L1.1, TPC1.1
/COMP1_INM: IC1.18 (PA4), J3.1
/COMP1_INP: IC1.25 (PB1), RS3.1, RS4.2, Z2.1 (K)
/COMP2_INM: IC1.19 (PA5), J4.1
/G1: Q1.2 (G), RH1.2, RL1.2, TPG1.1
/G2: Q2.2 (G), RH2.2, RL2.2, TPG2.1
/G3: Q3.2 (G), RH3.2, RL3.2, TPG3.1
/G4: Q4.2 (G), RH4.2, RL4.2, TPG4.1
/HRTIM1_CHA1: IC1.42 (PA8), IC4.3 (INB)
/HRTIM1_CHA2: IC1.43 (PA9), IC4.2 (INA)
/HRTIM1_CHB1: IC1.44 (PA10), IC3.3 (INB)
/HRTIM1_CHB2: IC1.45 (PA11), IC3.2 (INA)
/HRTIM1_CHC1: IC1.34 (PB12), IC6.3 (INB)
/HRTIM1_CHC2: IC1.35 (PB13), IC6.2 (INA)
/HRTIM1_CHD1: IC1.36 (PB14), IC5.3 (INB)
/HRTIM1_CHD2: IC1.37 (PB15), IC5.2 (INA)
/IG1RH: IC11.A2 (OUTH), RH1.1
/IG1RL: IC11.B2 (OUTL), RL1.1
/IG2RH: IC12.A2 (OUTH), RH2.1
/IG2RL: IC12.B2 (OUTL), RL2.1
/IG3RH: IC13.A2 (OUTH), RH3.1
/IG3RL: IC13.B2 (OUTL), RL3.1
/IG4RH: IC14.A2 (OUTH), RH4.1
/IG4RL: IC14.B2 (OUTL), RL4.1
/INN1: IC3.6 (OUTB), IC11.C2 (IN-)
/INN2: IC4.6 (OUTB), IC12.C2 (IN-)
/INN3: IC5.6 (OUTB), IC13.C2 (IN-)
/INN4: IC6.6 (OUTB), IC14.C2 (IN-)
/INP1: IC3.7 (OUTA), IC11.C1 (IN+)
/INP2: IC4.7 (OUTA), IC12.C1 (IN+)
/INP3: IC5.7 (OUTA), IC13.C1 (IN+)
/INP4: IC6.7 (OUTA), IC14.C1 (IN+)
/NRST: CM9.1, D1.1 (K), IC1.7 (PG10-NRST), J1.5, S1.1 (COM_1), S1.2 (COM_2)
/OSC24_IN: COH2.2, IC1.5 (PF0-OSC_IN), Y2.1 (CRYSTAL_1)
/OSC24_OUT: COH1.2, IC1.6 (PF1-OSC_OUT), Y2.3 (CRYSTAL_2)
/OSC32_IN: COL1.2, IC1.3 (PC14-OSC32_IN), Y1.1
/OSC32_OUT: COL2.2, IC1.4 (PC15-OSC32_OUT), Y1.2
/S1: C1.1, CD1.2, CFT1.2 (GND_1), CFT1.4 (GND_2), CISOS1.2, CTS1.2, CTSB1.2, IC3.5 (GND2), IC7.9 (GNDS_1), IC7.10 (NC_4), IC7.11 (NC_5), IC7.12 (NC_6), IC7.15 (GNDS_2), IC7.16 (GNDS_3), IC11.B1 (GND), Q1.3 (S), Q2.1 (D), TPS1.1
/S2: C3.1, CD2.2, CFT2.2 (GND_1), CFT2.4 (GND_2), CISOS2.2, CTS2.2, CTSB2.2, IC4.5 (GND2), IC8.9 (GNDS_1), IC8.10 (NC_4), IC8.11 (NC_5), IC8.12 (NC_6), IC8.15 (GNDS_2), IC8.16 (GNDS_3), IC12.B1 (GND), P2.1, Q2.3 (S), Q3.1 (D), RS1.1, RS4.1
/S3: C2.2, CD3.2, CFT3.2 (GND_1), CFT3.4 (GND_2), CISOS3.2, CTS3.2, CTSB3.2, IC5.5 (GND2), IC9.9 (GNDS_1), IC9.10 (NC_4), IC9.11 (NC_5), IC9.12 (NC_6), IC9.15 (GNDS_2), IC9.16 (GNDS_3), IC13.B1 (GND), L1.2, Q3.3 (S), Q4.1 (D), TPS3.1
/STLINK_RX: IC1.14 (PA2), J2.2
/STLINK_TX: IC1.17 (PA3), J2.1
/TPSFB: IC2.9 (FB), RF1.2, RF2.2
/T_SWCLK: IC1.50 (PA14), J1.2
/T_SWDIO: IC1.49 (PA13), J1.4
/UBUTT: D2.1 (K), IC1.2 (PC13), RUB1.2, S2.3 (NO_1), S2.4 (NO_2)
/VDD3V3: BEAD1.1, BEAD2.1, CISOP1.1, CISOP2.1, CISOP3.1, CISOP4.1, CLD2.1, CM0.2, CM1.1, CM2.1, CM3.1, CM4.1, CM5.1, CM6.2, IC1.1 (VBAT), IC1.16 (VDD_1), IC1.32 (VDD_2), IC1.48 (VDD_3), IC1.64 (VDD_4), IC3.1 (VCC1), IC4.1 (VCC1), IC5.1 (VCC1), IC6.1 (VCC1), J1.1, PS1.4 (VOUT), S2.1 (COM_1), S2.2 (COM_2)
/VDD5V: CCV1.1, CCV2.1, CLD1.1, CTP1.1, CTP2.1, CTP3.1, CTP4.1, CTPB1.1, CTPB2.1, CTPB3.1, CTPB4.1, IC2.7 (VOUT_1), IC2.8 (VOUT_2), IC7.1 (EN), IC7.3 (VINP), IC8.1 (EN), IC8.3 (VINP), IC9.1 (EN), IC9.3 (VINP), IC10.1 (EN), IC10.3 (VINP), PS1.1 (EN), PS1.6 (VIN), RF1.1
/VDD48V: CIN1.1, CIN2.1, CPIN1.1, CPIN2.1, IC2.1 (VIN_1), IC2.2 (EN), IC2.14 (VIN_2), JP1.1 (A), JP1.2 (B), P1.1, Q1.1 (D), RS8.1
/VDDI1: CD1.1, CFT1.1 (IN), CISOS1.1, CTS1.1, CTSB1.1, IC3.8 (VCC2), IC7.13 (SEL), IC7.14 (VISO)
/VDDI2: CD2.1, CFT2.1 (IN), CISOS2.1, CTS2.1, CTSB2.1, IC4.8 (VCC2), IC8.13 (SEL), IC8.14 (VISO)
/VDDI3: CD3.1, CFT3.1 (IN), CISOS3.1, CTS3.1, CTSB3.1, IC5.8 (VCC2), IC9.13 (SEL), IC9.14 (VISO)
/VDDI4: CD4.1, CFT4.1 (IN), CISOS4.1, CTS4.1, CTSB4.1, IC6.8 (VCC2), IC10.13 (SEL), IC10.14 (VISO)
/VREFP: BEAD2.2, CM7.2, CM8.1, IC1.28 (VREF+)
GND: C3.2, CCV1.2, CCV2.2, CD4.2, CFT4.2 (GND_1), CFT4.4 (GND_2), CIN1.2, CIN2.2, CISOP1.2, CISOP2.2, CISOP3.2, CISOP4.2, CISOS4.2, CLD1.2, CLD2.2, CM0.1, CM1.2, CM2.2, CM3.2, CM4.2, CM5.2, CM6.1, CM7.1, CM8.2, CM9.2, CM10.2, COH1.1, COH2.1, COL1.1, COL2.1, CPIN1.2, CPIN2.2, CTP1.2, CTP2.2, CTP3.2, CTP4.2, CTPB1.2, CTPB2.2, CTPB3.2, CTPB4.2, CTS4.2, CTSB4.2, D1.2 (A), D2.2 (A), IC1.15 (VSS_1), IC1.27 (VSSA), IC1.31 (VSS_2), IC1.47 (VSS_3), IC1.63 (VSS_4), IC2.10 (AGND), IC2.12 (PGOOD), IC2.15 (PGND_1), IC2.A15 (PGND_2), IC2.B15 (PGND_3), IC3.4 (GND1), IC4.4 (GND1), IC5.4 (GND1), IC6.4 (GND1), IC6.5 (GND2), IC7.2 (GNDP), IC7.4 (SYNC), IC7.6 (NC_1), IC7.7 (NC_2), IC7.8 (NC_3), IC8.2 (GNDP), IC8.4 (SYNC), IC8.6 (NC_1), IC8.7 (NC_2), IC8.8 (NC_3), IC9.2 (GNDP), IC9.4 (SYNC), IC9.6 (NC_1), IC9.7 (NC_2), IC9.8 (NC_3), IC10.2 (GNDP), IC10.4 (SYNC), IC10.6 (NC_1), IC10.7 (NC_2), IC10.8 (NC_3), IC10.9 (GNDS_1), IC10.10 (NC_4), IC10.11 (NC_5), IC10.12 (NC_6), IC10.15 (GNDS_2), IC10.16 (GNDS_3), IC14.B1 (GND), J1.3, J5.1, P1.2, P2.2, PS1.2 (GND), PS1.7 (PAD), Q4.3 (S), RF2.1, RM1.2, RS2.2, RS3.2, RS7.2, RUB2.2, S1.3 (NO_1), S1.4 (NO_2), Y2.2 (GND_1), Y2.4 (GND_2), Z1.2 (A), Z2.2 (A), Z3.2 (A)
unnamed: CFT1.3 (OUT), IC11.A1 (VDD)
unnamed: CFT2.3 (OUT), IC12.A1 (VDD)
unnamed: CFT3.3 (OUT), IC13.A1 (VDD)
unnamed: CFT4.3 (OUT), IC14.A1 (VDD)
unnamed: CM10.1, RUB1.1, RUB2.1
unnamed: IC1.61 (PB8-BOOT0), RM1.1
unnamed: BEAD1.2, IC1.29 (VDDA)

Notes on the sheet:
BOTTONI
MICRO
Connettori
OSCILLATORI
DCDC 48V to 5V
SENSING
LDO

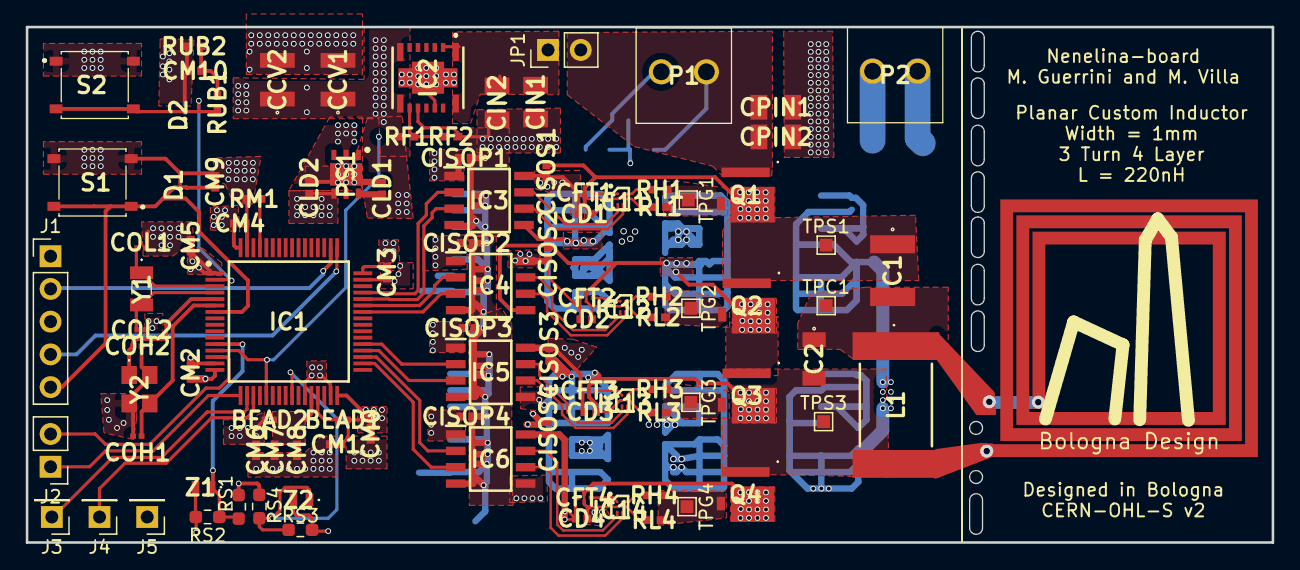
[picture p6: board Project.kicad_pcb from above]

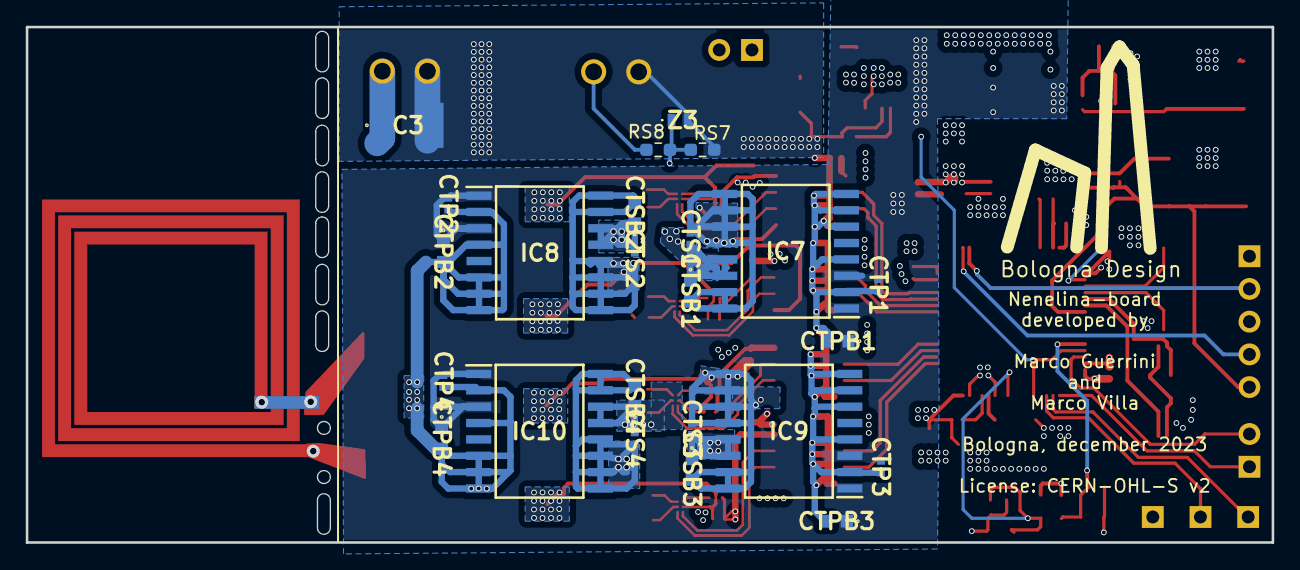
[picture p7: board Project.kicad_pcb from below]

Board: 4 copper layers, 96.7 x 40.0 mm, 123 parts (24 on the bottom side), 64 nets.
