gremirarunico/PCBs/MuReSC_GaN_firmware/MuReSC_GaN.ioc

Mcu.UserName=STM32G474RETx
PA10.Signal=HRTIM1_CHB1
PA11.Signal=HRTIM1_CHB2
PA13.GPIO_Label=T_SWDIO
PA13.Signal=SYS_JTMS-SWDIO
PA14.GPIO_Label=T_SWCLK
PA14.Signal=SYS_JTCK-SWCLK
PA2.GPIO_Label=LPUART1_TX [STLINKV3E_VCP_RX]
PA2.Signal=LPUART1_TX
PA3.GPIO_Label=LPUART1_RX [STLINKV3E_VCP_TX]
PA3.Signal=LPUART1_RX
PA4.Signal=COMP_DAC11_group
PA8.Signal=HRTIM1_CHA1
PA9.Signal=HRTIM1_CHA2
PB1.Signal=COMP1_INP
PB12.Signal=HRTIM1_CHC1
PB13.Signal=HRTIM1_CHC2
PB14.Signal=HRTIM1_CHD1
PB15.Signal=HRTIM1_CHD2
PC13.GPIO_Label=USER_BUTTON
PC13.Signal=GPIO_Input
PC14-OSC32_IN.Signal=RCC_OSC32_IN
PC15-OSC32_OUT.Signal=RCC_OSC32_OUT
PF0-OSC_IN.Signal=RCC_OSC_IN
PF1-OSC_OUT.Signal=RCC_OSC_OUT
