gremirarunico/PCBs/MuReSC_GaN_firmware/Core/Inc/main.h

#define USER_BUTTON_Pin GPIO_PIN_13
#define USER_BUTTON_GPIO_Port GPIOC
#define LPUART1_TX_Pin GPIO_PIN_2
#define LPUART1_TX_GPIO_Port GPIOA
#define LPUART1_RX_Pin GPIO_PIN_3
#define LPUART1_RX_GPIO_Port GPIOA
#define T_SWDIO_Pin GPIO_PIN_13
#define T_SWDIO_GPIO_Port GPIOA
#define T_SWCLK_Pin GPIO_PIN_14
#define T_SWCLK_GPIO_Port GPIOA
