gremirarunico/PCBs/(commit log)

2023-10-30 prima versione
    [Bom_PER_LIBRERIA.xlsx, Project.kicad_pcb, Project.kicad_sch]
2023-10-30 finito schema
    [Project.kicad_pcb, Project.kicad_sch]
2023-10-31 schematic finished + start layout
    [Project.kicad_pcb, Project.kicad_sch]
2023-10-31 layout prosegue
    [Project.kicad_pcb]
2023-11-02 lauyout update
    [Project.kicad_pcb]
2023-11-02 layout avanti
    [Project.kicad_pcb]
2023-11-03 quasi finito
    [Project.kicad_pcb, Project.kicad_sch]
2023-11-03 LAYOUT DRC
    [Project.kicad_pcb, Project.kicad_sch]
2023-11-22 footprint correction
    [Project.kicad_pcb]
2024-02-08 test ADC
2024-02-19 auto read ADC and control
2024-09-25 disabled ADC from mx cube
2024-10-09 update MuReSC_GaN_v1
    [Bom.xlsx, Project.kicad_pcb]
2024-10-09 init project for BCD measure board
    [MuReSC_BCD.kicad_pcb, MuReSC_BCD.kicad_sch]
2024-11-05 Bug correction
    [BOM.xlsx, MuReSC_BCD.kicad_pcb, MuReSC_BCD.kicad_sch]
2025-04-16 up footprint
