gremirarunico/PCBs/(notices)

Notices in the files:
MuReSC_GaN_firmware/Core/Inc/main.h:
Copyright (c) 2023 STMicroelectronics.
All rights reserved.
This software is licensed under terms that can be found in the LICENSE file
MuReSC_GaN_v1/Project.kicad_pcb:
License: CERN-OHL-S v2
